sgilleo/stm32f7-Flight-Controller/README.md

# STM32F7 DIY Flight Controller

Board Image

A custom-designed **flight controller PCB** for UAV applications, built around the powerful **STM32F722 microcontroller** and the **ICM-42688-P 6-axis IMU**. This board integrates multiple peripherals to provide high-performance sensing, control, and communication capabilities for drones and robotics projects.  

---

## ✈️ Features  

- **Main MCU**: STMicroelectronics **STM32F722**  
  - ARM Cortex-M7 core @ 216 MHz  
  - Floating Point Unit (FPU)  
  - High-speed SPI/I²C/UART interfaces  
  - USB OTG support  

- **Inertial Measurement Unit (IMU)**: **ICM-42688-P**  
  - 3-axis gyroscope + 3-axis accelerometer  
  - Low noise, low drift  
  - High sample rates for stable flight control  

- **Connectivity & Expansion**  
  - Multiple UARTs for GPS, telemetry, and RC receivers (SBUS/DSM/SRXL/CRSF, etc.)
  - Supports native UART level inversion for some protocols (SBUS)
  - I²C breakout for additional sensors  
  - PWM outputs for ESCs and servos  
  - USB-C for firmware flashing and configuration
  - SWD Port for flashing, debugging and real time monitoring  

- **Power Management**  
  - Designed for wide input voltage range from LiPo batteries (2S-6S)  
  - Integrated 5V 6A BEC for servos
  - Dedicated 3.3V regulators for the MCU and IMU to minimize noise  
  - Pads for battery connector and ESC
  - **Important:** external electrolytic capacitor needed to prevent voltage spikes (e.g. 35V 560µF)  

---

## 📐 PCB Design  

- Designed in **EasyEDA** to maximize compatibility with **LCSC Parts**.
- Compact form factor optimized for UAV mounting  
- 2-layer PCB design
- Manufactured by **JLCPCB**

PCB Schematic

---

## 🛠️ Firmware Compatibility  

This flight controller is designed to be compatible with popular open-source UAV firmware projects such as:  

- [Betaflight](https://betaflight.com/)  

However, the purpose of this project is to develop a fully custom flight software, including the drivers for all the peripherals, the AHRS, PIDs, Flight Modes and Input/Output Management.

---

## 🚀 Getting Started  

1. **Hardware**  
   - Assemble or order the PCB (Gerber files are provided).  
   - Populate with components (BOM included).  

2. **Firmware**  
   - In order to flash the board you need ST's CubeIDE Software
   - Open the project
   - Configure sensor orientation, peripherals, outputs, channels and PIDs in the firmware.  
   - Flash the firmware via USB DFU or SWD port.  

3. **Connections**  
   - Connect GPS, telemetry radio, RC receiver, and ESCs.  
   - Power the board via LiPo battery or USB-C for testing.
