sgilleo/stm32f7-Flight-Controller/BOM_STM32F7-FC_2025-08-01.csv

ID | Name | Designator | Footprint | Quantity | Manufacturer Part | Manufacturer | Supplier | Supplier Part | Price
1 | 5.1kΩ | R4,R5 | R0402 | 2 | 0402WGF5101TCE | UNI-ROYAL(厚声) | LCSC | C25905 | 0.001
2 | 10nF | C1,C4,C9,C27 | C0402 | 4 | CL05B103KB5NNNC | SAMSUNG(三星) | LCSC | C15195 | 0.001
3 | 100nF | C5,C11,C12,C13,C14,C15,C18,C19,C20,C21,C24,C32 | C0402 | 12 | CL05B104KO5NNNC | SAMSUNG(三星) | LCSC | C1525 | 0.001
4 | 2.2uF | C6 | C0402 | 1 | CL05A225MQ5NSNC | SAMSUNG(三星) | LCSC | C12530 | 0.003
5 | 100nF | C22,C29 | C0402 | 2 | CL05B104KB54PNC | SAMSUNG(三星) | LCSC | C307331 | 0.005
6 | 1uF | C2,C8,C17 | C0603 | 3 | CL10A105KB8NNNC | SAMSUNG(三星) | LCSC | C15849 | 0.005
7 | 10uF | C3,C7,C16 | C0603 | 3 | CL10A106KP8NNNC | SAMSUNG(三星) | LCSC | C19702 | 0.006
8 | 4.7uF | C10 | C0603 | 1 | CL10A475KO8NNNC | SAMSUNG(三星) | LCSC | C19666 | 0.01
9 | 10uF | C23,C28 | C0805 | 2 | CL21A106KAYNNNE | SAMSUNG(三星) | LCSC | C15850 | 0.011
10 | 22uF | C25,C26 | C0805 | 2 | CL21A226MAQNNNE | SAMSUNG(三星) | LCSC | C45783 | 0.024
11 | 47uF | C30,C31 | C0805 | 2 | CL21A476MQYNNNE | SAMSUNG(三星) | LCSC | C16780 | 0.028
12 | USBLC6-2SC6 | D1 | SOT-23-6_L2.9-W1.6-P0.95-LS2.8-BL | 1 | USBLC6-2SC6 | ST(意法半导体) | LCSC | C7519 | 0.111
13 | TPS54202DDCR | U5 | SOT-23-6_L2.9-W1.6-P0.95-LS2.8-BL | 1 | TPS54202DDCR | TI(德州仪器) | LCSC | C191884 | 0.119
14 | BAT54C,215 | D2 | SOT-23-3_L2.9-W1.6-P1.90-LS2.8-BR | 1 | BAT54C,215 | Nexperia(安世) | LCSC | C37704 | 0.009
15 | B540C-13-F | D3 | SMC_L7.1-W6.2-LS8.1-RD | 1 | B540C-13-F | DIODES(美台) | LCSC | C72264 | 0.1
16 | 10uH | L1 | IND-SMD_L4.5-W4.1_SL0420 | 1 | SL0420-100M | 台湾陆海 | LCSC | C22463809 | 0.117
17 | 10uH | L2 | IND-SMD_L7.1-W6.6 | 1 | SL0630-100M | 台湾陆海 | LCSC | C22463823 | 0.073
18 | KT-0603R | LED1 | LED0603-RD | 1 | KT-0603R | KENTO | LCSC | C2286 | 0.006
19 | 0805G (Green) | LED2 | LED0805-R-RD | 1 | KT-0805G | KENTO | LCSC | C2297 | 0.011
20 | 1kΩ | R1,R13 | R0402 | 2 | 0402WGF1001TCE | UNI-ROYAL(厚声) | LCSC | C11702 | 0.001
21 | 4.7kΩ | R2,R3 | R0402 | 2 | 0402WGF4701TCE | UNI-ROYAL(厚声) | LCSC | C25900 | 0.001
22 | 10kΩ | R6,R10 | R0402 | 2 | 0402WGF1002TCE | UNI-ROYAL(厚声) | LCSC | C25744 | 0.001
23 | 100kΩ | R7 | R0402 | 1 | 0402WGF1003TCE | UNI-ROYAL(厚声) | LCSC | C25741 | 0.001
24 | 13.3kΩ | R8 | R0402 | 1 | 0402WGF1332TCE | UNI-ROYAL(厚声) | LCSC | C122547 | 0.001
25 | 3.16kΩ | R9 | R0402 | 1 | 0402WGF3161TCE | UNI-ROYAL(厚声) | LCSC | C11462 | 0.001
26 | 10kΩ | R11 | R0603 | 1 | 0603WAF1002T5E | UNI-ROYAL(厚声) | LCSC | C25804 | 0.001
27 | 100kΩ | R12 | R0603 | 1 | 0603WAF1003T5E | UNI-ROYAL(厚声) | LCSC | C25803 | 0.001
28 | TS-1088-AR02016 | SW1 | SW-SMD_L3.9-W3.0-P4.45 | 1 | TS-1088-AR02016 | XUNPU(讯普) | LCSC | C720477 | 0.043
29 | STM32F722RET6 | U1 | LQFP-64_L10.0-W10.0-P0.50-LS12.0-BL | 1 | STM32F722RET6 | ST(意法半导体) | LCSC | C118207 | 6.668
30 | ICM-42688-P | U2 | LGA-14_L3.0-W2.5-P0.50-TL | 1 | ICM-42688-P | TDK InvenSense(应美盛) | LCSC | C1850418 | 2.531
31 | SPX3819M5-L-3-3/TR | U3,U6 | SOT-23-5_L3.0-W1.7-P0.95-LS2.8-BL | 2 | SPX3819M5-L-3-3/TR | MaxLinear(迈凌) | LCSC | C9055 | 0.185
32 | BMP388 | U4 | SENSORM-SMD_BMP388 | 1 | BMP388 | Bosch(博世) | LCSC | C779278 | 1.22
33 | TPS5450DDAR | U7 | SOP-8_L4.9-W3.9-P1.27-LS6.0-BL-EP | 1 | TPS5450DDAR | TI(德州仪器) | LCSC | C114425 | 0.719
34 | TYPE-C 16PIN 2MD(073) | USB1 | USB-C-SMD_TYPE-C-6PIN-2MD-073 | 1 | TYPE-C 16PIN 2MD(073) | SHOU HAN(首韩) | LCSC | C2765186 | 0.057
35 | 8MHz | X1 | OSC-SMD_3P-L3.2-W1.3-P1.20 | 1 | CSTNE8M00G520000R0 | muRata(村田) | LCSC | C907975 | 0.178
