sgilleo/stm32f7-Flight-Controller/Schematic_STM32F7-FC_2025-08-11.pdf

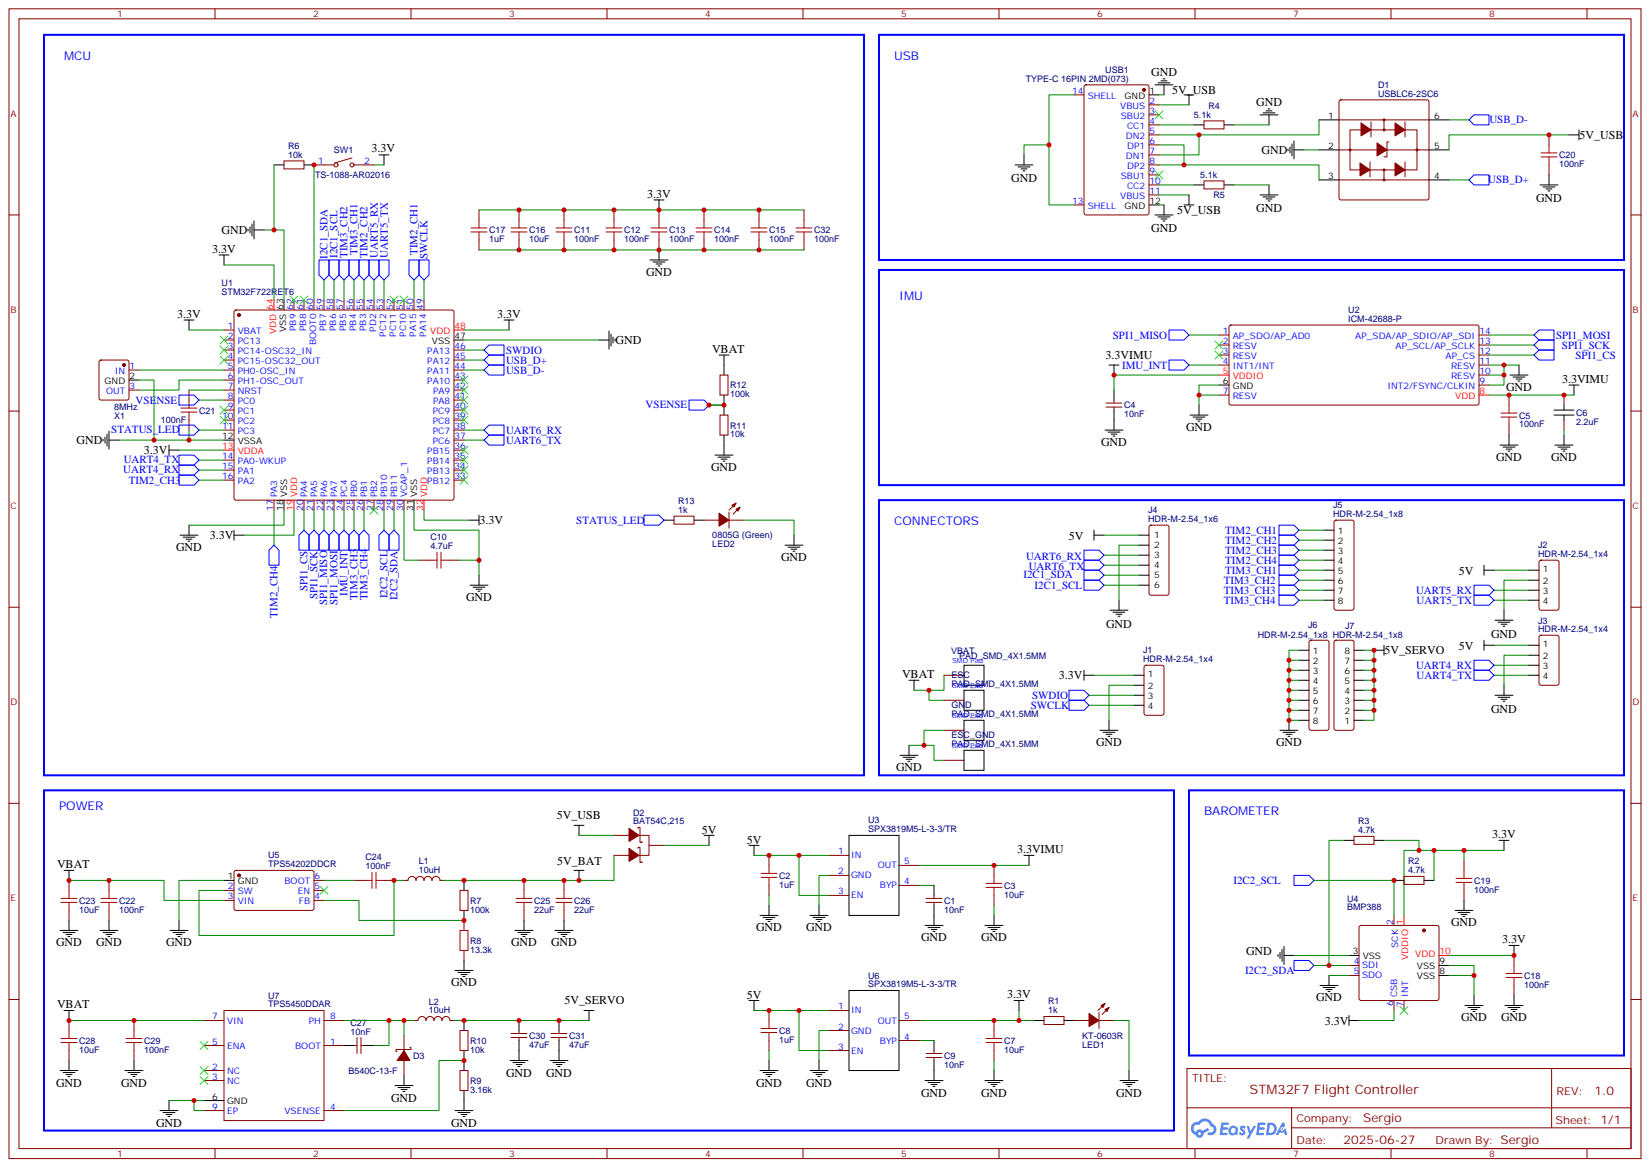
[picture p1: page 1]
