sgilleo/stm32f7-Flight-Controller/Core/Src/main.c

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
/* Includes ------------------------------------------------------------------*/
#include "main.h"
#include "usb_device.h"

/* USER CODE BEGIN Includes */

#include <math.h>
#include "usbd_cdc_if.h"
#include "ICM42688P.h"
#include "Outputs.h"
#include "Sbus.h"
//#include "Quaternion.h"
#include "Flight_Modes.h"
#include "AHRS.h"
#include "PIDs.h"
#include "Battery.h"
#include "Parameters.h"
#include "USB.h"

/* USER CODE END Includes */

/* USER CODE BEGIN PD */

#define DELTA_T 0.01


/* USER CODE END PD */

ADC_HandleTypeDef hadc1;
DMA_HandleTypeDef hdma_adc1;

I2C_HandleTypeDef hi2c1;

SPI_HandleTypeDef hspi1;
DMA_HandleTypeDef hdma_spi1_rx;
DMA_HandleTypeDef hdma_spi1_tx;

TIM_HandleTypeDef htim2;
TIM_HandleTypeDef htim3;

UART_HandleTypeDef huart4;
UART_HandleTypeDef huart5;
UART_HandleTypeDef huart6;
DMA_HandleTypeDef hdma_uart4_rx;

void SystemClock_Config(void);
static void MPU_Config(void);
static void MX_GPIO_Init(void);
static void MX_DMA_Init(void);
static void MX_ADC1_Init(void);
static void MX_I2C1_Init(void);
static void MX_SPI1_Init(void);
static void MX_TIM2_Init(void);
static void MX_TIM3_Init(void);
static void MX_UART4_Init(void);
static void MX_UART5_Init(void);
static void MX_USART6_UART_Init(void);
/* USER CODE BEGIN 0 */

Sbus receiver;
ICM42688 imu;

extern Battery battery;

char usbBuffer[50];

extern Vec3 attitude;
extern Vec3 ref;
extern uint16_t outputs[8];
extern float functions[10];

extern Flight_Mode flight_mode;

uint32_t timer = 0;
extern Arming arming;
extern ParameterTable parameters, default_parameters;
extern uint8_t usbRxBuffer[20];

void HAL_UARTEx_RxEventCallback(UART_HandleTypeDef *huart, uint16_t Size){
	if(huart->Instance == huart4.Instance){

		if(receiver.buffer[0] == 0x0F && receiver.buffer[24] == 0x00) {
			Sbus_decode(&receiver);
			receiver.dataRdy = 1;
		}
		else{
			receiver.dataRdy = 0;
			HAL_UART_AbortReceive(&huart4);
			HAL_UARTEx_ReceiveToIdle_DMA(&huart4, receiver.buffer, 25);
		}
	}
}

void HAL_GPIO_EXTI_Callback(uint16_t GPIO_Pin){

	if(GPIO_Pin == IMU_INT_Pin){
		if(imu.ready){
			ICM42688_Read_DMA(&imu);
		}

	}

}

void HAL_SPI_TxRxCpltCallback(SPI_HandleTypeDef *hspi){
	if(hspi->Instance == hspi1.Instance){
		HAL_GPIO_WritePin(SPI1_CS_GPIO_Port, SPI1_CS_Pin, GPIO_PIN_SET);

		ICM42688_Process_Buffer(&imu);
		imu.dataRdy = 1;
	}
}




/* USER CODE END 0 */

/**
  * @brief  The application entry point.
  * @retval int
  */
int main(void)
{

  /* MPU Configuration--------------------------------------------------------*/
  MPU_Config();

  /* MCU Configuration--------------------------------------------------------*/

  /* Reset of all peripherals, Initializes the Flash interface and the Systick. */
  HAL_Init();

  /* Configure the system clock */
  SystemClock_Config();

  /* Initialize all configured peripherals */
  MX_GPIO_Init();
  MX_DMA_Init();
  MX_ADC1_Init();
  MX_I2C1_Init();
  MX_SPI1_Init();
  MX_TIM2_Init();
  MX_TIM3_Init();
  MX_UART4_Init();
  MX_UART5_Init();
  MX_USART6_UART_Init();
  MX_USB_DEVICE_Init();
  /* USER CODE BEGIN 2 */


  //Start Sbus Reception and Sync
  if(Sbus_Begin(&huart4, &receiver) != HAL_OK) {
	  Error_Handler();
  }

  //Start IMU, configure ranges, filters & interrupts
  if(ICM42688_Begin(&imu, &hspi1) != HAL_OK) {
	  Error_Handler();
  }

  //Start DMA Read for Vbat ADC
  if(Battery_Begin(&hadc1) != HAL_OK) {
	  Error_Handler();
  }

  //Configure output timers
  if(Output_Begin(&htim2, &htim3) != HAL_OK) {
	  Error_Handler();
  }

  //Load Parameters from FLASH
  if(Load_Parameters(&parameters) != HAL_OK){
	  Save_Parameters(&default_parameters);
	  if(Load_Parameters(&parameters) != HAL_OK){
		  Error_Handler();
	  }
  }





  /* USER CODE END 2 */

  /* Infinite loop */
  /* USER CODE BEGIN WHILE */
  while (1)
  {

	if ((HAL_GetTick() - timer) >= DELTA_T*1000) {

		Battery_Update();

		if(imu.dataRdy){

			AHRS_Update_Complementary_Filter(imu.gyro, imu.accel, 0.8, DELTA_T);

		}

		if(receiver.dataRdy){

			Process_Input(receiver);

			if(flight_mode == ACRO_MODE) Acro_Mode(receiver, DELTA_T);
			else if (flight_mode == STABILIZED_MODE) Stabilized_Mode(receiver, DELTA_T);
			else if(flight_mode == MANUAL_MODE) Manual_Mode(receiver);

		}

		Output_Update(&htim2, &htim3);



		timer += DELTA_T*1000;

	}




    /* USER CODE END WHILE */

    /* USER CODE BEGIN 3 */
  }
  /* USER CODE END 3 */
}

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
 /* MPU Configuration */

void MPU_Config(void)
{
  MPU_Region_InitTypeDef MPU_InitStruct = {0};

  /* Disables the MPU */
  HAL_MPU_Disable();

  /** Initializes and configures the Region and the memory to be protected
  */
  MPU_InitStruct.Enable = MPU_REGION_ENABLE;
  MPU_InitStruct.Number = MPU_REGION_NUMBER0;
  MPU_InitStruct.BaseAddress = 0x0;
  MPU_InitStruct.Size = MPU_REGION_SIZE_4GB;
  MPU_InitStruct.SubRegionDisable = 0x87;
  MPU_InitStruct.TypeExtField = MPU_TEX_LEVEL0;
  MPU_InitStruct.AccessPermission = MPU_REGION_NO_ACCESS;
  MPU_InitStruct.DisableExec = MPU_INSTRUCTION_ACCESS_DISABLE;
  MPU_InitStruct.IsShareable = MPU_ACCESS_SHAREABLE;
  MPU_InitStruct.IsCacheable = MPU_ACCESS_NOT_CACHEABLE;
  MPU_InitStruct.IsBufferable = MPU_ACCESS_NOT_BUFFERABLE;

  HAL_MPU_ConfigRegion(&MPU_InitStruct);
  /* Enables the MPU */
  HAL_MPU_Enable(MPU_PRIVILEGED_DEFAULT);

}

/**
  * @brief  This function is executed in case of error occurrence.
  * @retval None
  */
void Error_Handler(void)
{
  /* USER CODE BEGIN Error_Handler_Debug */
  /* User can add his own implementation to report the HAL error return state */
  __disable_irq();
  while (1)
  {
	  HAL_GPIO_TogglePin(STATUS_LED_GPIO_Port, STATUS_LED_Pin); //LED BLINK
	  for(int i = 0; i < 1000000; i++){
		  __NOP();
	  }
  }
  /* USER CODE END Error_Handler_Debug */
}
#ifdef USE_FULL_ASSERT
/**
  * @brief  Reports the name of the source file and the source line number
  *         where the assert_param error has occurred.
  * @param  file: pointer to the source file name
  * @param  line: assert_param error line source number
  * @retval None
  */
void assert_failed(uint8_t *file, uint32_t line)
{
  /* USER CODE BEGIN 6 */
  /* User can add his own implementation to report the file name and line number,
     ex: printf("Wrong parameters value: file %s on line %d\r\n", file, line) */
  /* USER CODE END 6 */
}
#endif /* USE_FULL_ASSERT */
