sgilleo/stm32f7-Flight-Controller/stm32f7-Flight-Controller.ioc

Mcu.UserName=STM32F722RETx
PA1.Signal=UART4_RX
PA11.Signal=USB_OTG_FS_DM
PA12.Signal=USB_OTG_FS_DP
PA13.Signal=SYS_JTMS-SWDIO
PA14.Signal=SYS_JTCK-SWCLK
PA15.Signal=S_TIM2_CH1_ETR
PA2.Signal=S_TIM2_CH3
PA3.Signal=S_TIM2_CH4
PA4.GPIO_Label=SPI1_CS
PA4.Signal=GPIO_Output
PA5.Signal=SPI1_SCK
PA6.Signal=SPI1_MISO
PA7.Signal=SPI1_MOSI
PB0.Signal=S_TIM3_CH3
PB1.Signal=S_TIM3_CH4
PB3.Signal=S_TIM2_CH2
PB4.Signal=S_TIM3_CH1
PB5.Signal=S_TIM3_CH2
PB6.Signal=I2C1_SCL
PB7.Signal=I2C1_SDA
PC0.Signal=ADCx_IN10
PC10.Signal=UART4_TX
PC12.Signal=UART5_TX
PC3.GPIO_Label=STATUS_LED
PC3.Signal=GPIO_Output
PC4.GPIO_Label=IMU_INT
PC4.Signal=GPXTI4
PC6.Signal=USART6_TX
PC7.Signal=USART6_RX
PD2.Signal=UART5_RX
PH0-OSC_IN.Signal=RCC_OSC_IN
PH1-OSC_OUT.Signal=RCC_OSC_OUT
