sgilleo/stm32f7-Flight-Controller/Core/Inc/main.h

#define STATUS_LED_Pin GPIO_PIN_3
#define STATUS_LED_GPIO_Port GPIOC
#define SPI1_CS_Pin GPIO_PIN_4
#define SPI1_CS_GPIO_Port GPIOA
#define IMU_INT_Pin GPIO_PIN_4
#define IMU_INT_GPIO_Port GPIOC
#define IMU_INT_EXTI_IRQn EXTI4_IRQn
