sgilleo/stm32f7-Flight-Controller/Core/Inc/Flight_Modes.h

/*
 * Flight_Modes.h
 *
 *  Created on: Aug 29, 2025
 *      Author: sergi
 */

#ifndef INC_FLIGHT_MODES_H_
#define INC_FLIGHT_MODES_H_

#include <math.h>
#include "Sbus.h"
#include "ICM42688P.h"
#include "Outputs.h"
#include "PIDs.h"
#include "Parameters.h"

/*#define STABILIZED_MAX_ROLL 45 //Degrees
#define STABILIZED_MAX_PITCH 45

#define ACRO_ROLL_RATE 180 //Full Stick Left/Right: Degrees / Second
#define ACRO_PITCH_RATE 180
#define ACRO_YAW_RATE 90*/

typedef enum{
	MANUAL_MODE,
	STABILIZED_MODE,
	ACRO_MODE
}Flight_Mode;

typedef enum{
	DISARMED,
	ARMED
}Arming;

void Stabilized_Mode(Sbus receiver, float dt);

void Acro_Mode(Sbus receiver, float dt);

void Manual_Mode(Sbus receiver);

void Process_Input(Sbus receiver);


#endif /* INC_FLIGHT_MODES_H_ */
