sgilleo/stm32f7-Flight-Controller/Core/Src/AHRS.c

/*
 * AHRS.c
 *
 *  Created on: Aug 30, 2025
 *      Author: sergi
 */


#include "AHRS.h"

Vec3 attitude_gyro, euler_rates_gyro, attitude_acc, attitude = {0.0f, 0.0f, 0.0f};

void AHRS_Update_Gyro(Vec3 gyro, float dt){

	euler_rates_gyro.x = gyro.x + gyro.y*sinf(attitude.x)*tanf(attitude.y) + gyro.z*cosf(attitude.x)*tanf(attitude.y);
	euler_rates_gyro.y = gyro.y*cosf(attitude.x) - gyro.z*sinf(attitude.x);
	euler_rates_gyro.z = gyro.y*sinf(attitude.x)/cosf(attitude.y) + gyro.z*cosf(attitude.x)/cosf(attitude.y);

	attitude_gyro.x = attitude.x + euler_rates_gyro.x * dt;
	attitude_gyro.y = attitude.y + euler_rates_gyro.y * dt;
	attitude_gyro.z = attitude.z + euler_rates_gyro.z * dt;

	if(attitude_gyro.x > M_PI || attitude_gyro.x <= -M_PI) attitude_gyro.x = -attitude_gyro.x;
	if(attitude_gyro.y > M_PI || attitude_gyro.y <= -M_PI) attitude_gyro.y = -attitude_gyro.y;
	if(attitude_gyro.z > M_PI || attitude_gyro.z <= -M_PI) attitude_gyro.z = -attitude_gyro.z;

}



void AHRS_Update_Acc(Vec3 accel){

	attitude_acc.x = atan2f(accel.y, accel.z);
	attitude_acc.y = atan2f(-accel.x, sqrt(accel.y*accel.y + accel.z*accel.z));
	attitude_acc.z = attitude_gyro.z;

}

//fc: Cutoff frequency for complementary filter (Hz)
void AHRS_Update_Complementary_Filter(Vec3 gyro, Vec3 acc, float fc, float dt){

	AHRS_Update_Gyro(gyro, dt);
	AHRS_Update_Acc(acc);

	float tau = 1/(2*M_PI*fc);
	float gain = tau/(tau+dt); //Gain depends on dt

	attitude.x = gain*attitude_gyro.x + (1-gain)*attitude_acc.x;
	attitude.y = gain*attitude_gyro.y + (1-gain)*attitude_acc.y;
	attitude.z = gain*attitude_gyro.z + (1-gain)*attitude_acc.z;

}
