sgilleo/stm32f7-Flight-Controller/(commit log)

2025-08-31 Fixed Sbus Sync Issue
    [Sbus.c, Sbus.h, main.c, stm32f7-Flight-Controller.ioc]
2025-09-02 Added Motor Arming & Cleaned some Code
2025-09-03 Fixed Gyro Reference Frame & Added Production Files
    [BOM_STM32F7-FC_2025-08-01.csv, PickAndPlace_PCB_STM32F7-FC_2025-08-01.csv]
2025-09-03 Fixed complementary filter alpha & work on ACRO mode PID
    [AHRS.c, Flight_Modes.c, Flight_Modes.h, ICM42688P.c, Outputs.h, PIDs.c, PIDs.h, main.c]
2025-09-03 Added Low Pass Filters to Derivative part of PID
