sgilleo/stm32f7-Flight-Controller/(notices)

Notices in the files:
Core/Src/main.c:
Copyright (c) 2025 STMicroelectronics.
All rights reserved.
This software is licensed under terms that can be found in the LICENSE file
